bradkim06/eeg_hw/README.md

# Project Goal

기존 외주 뇌파모듈을 더 좋은 성능과 가격으로 대체

## Schematic

[v0.2-dev](./doc/eeg.pdf)
