bradkim06/eeg_hw/doc/20240610/pcb_layout_20240610.png

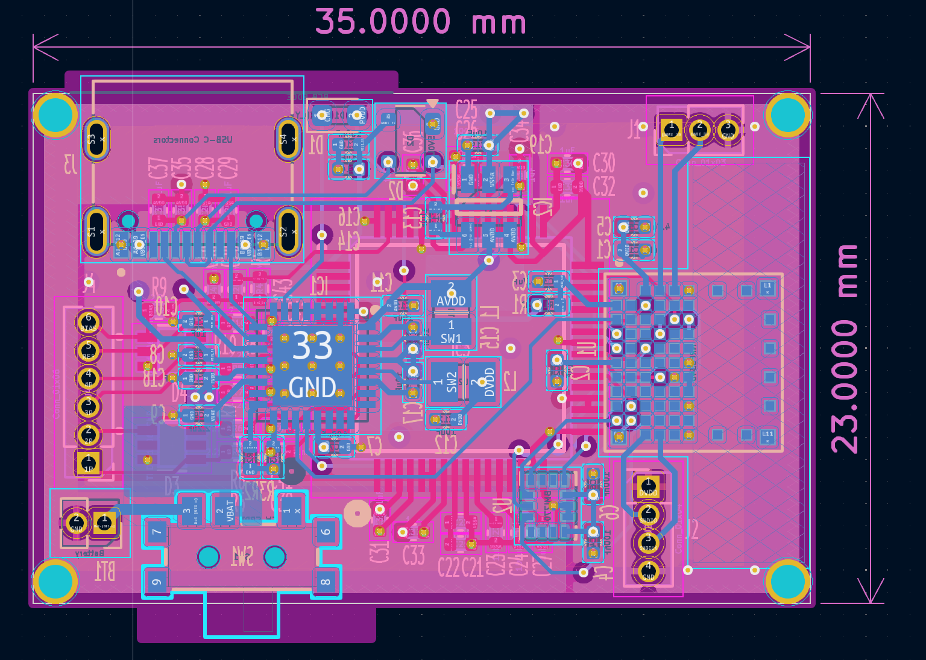
doc/20240610/pcb_layout_20240610.png
