bradkim06/eeg_hw/doc/20240610/schematic_20240610.pdf

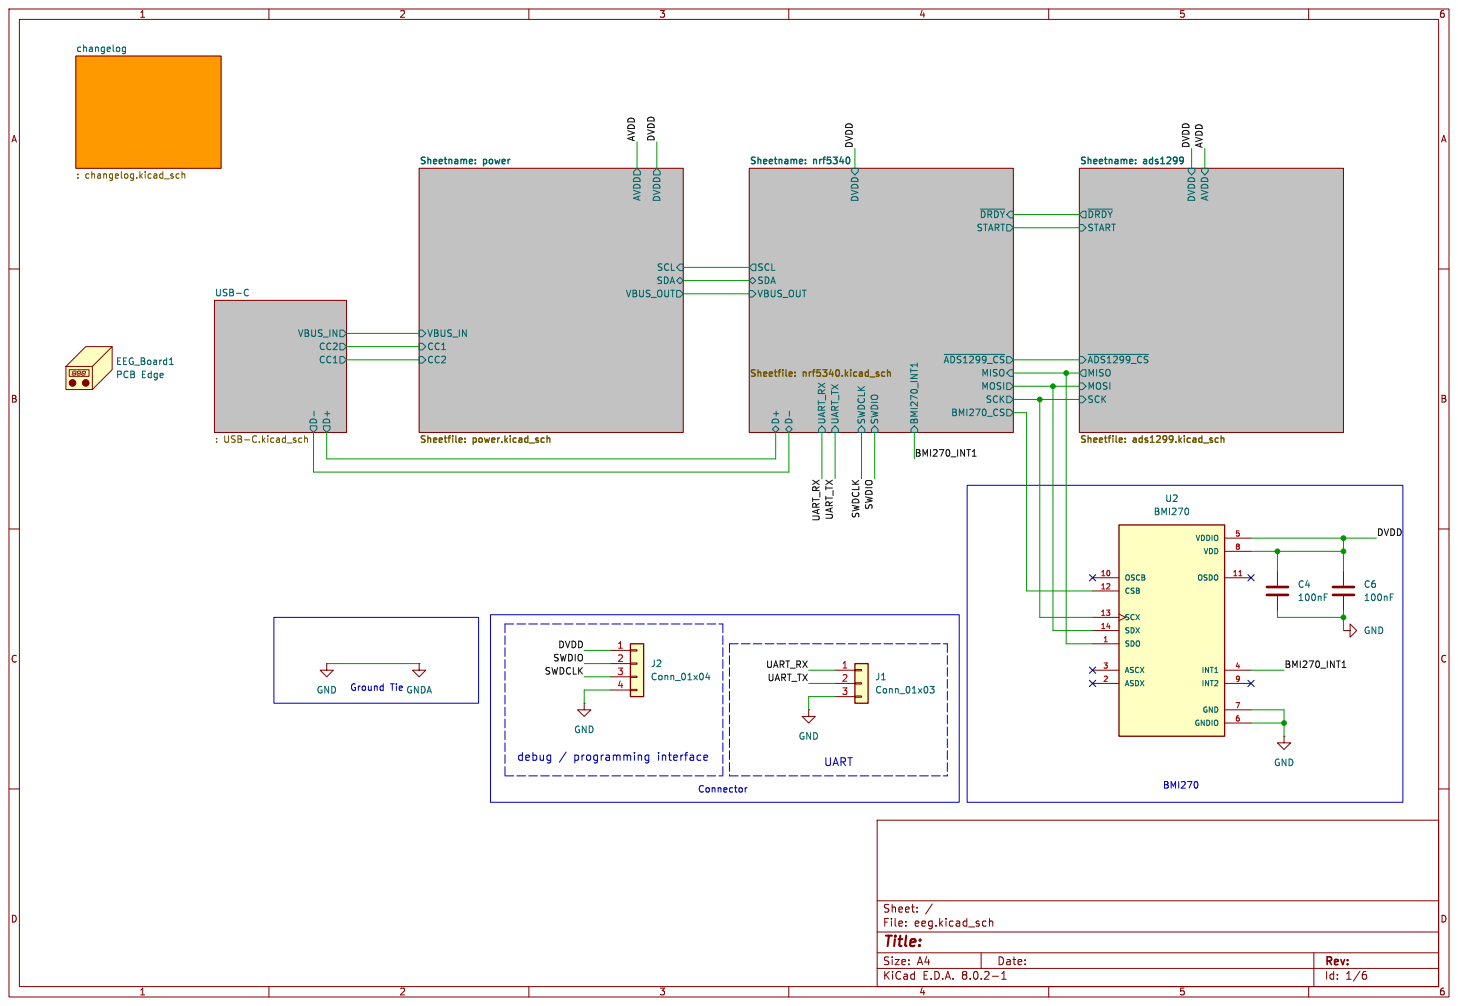
[picture p2: page 1]

Sheetname: power Sheetfile: power.kicad_sch

~{DRDY} START Sheetname: ads1299 Sheetfile: ads1299.kicad_sch

Id: 1/6 Title: File: eeg.kicad_sch Sheet: / D- D+ CC1 CC2 VBUS_IN

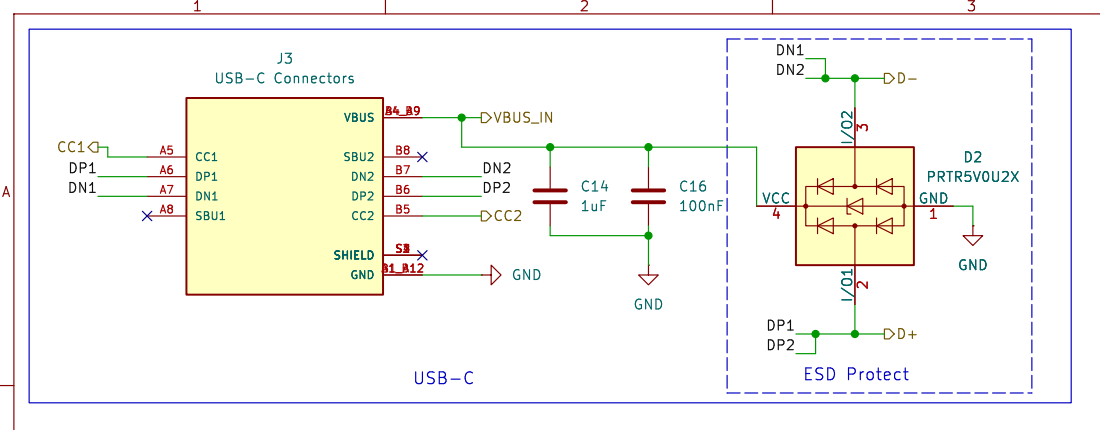
[picture p3: page 2]

Id: 2/6 Title: File: USB-C.kicad_sch Sheet: /USB-C/

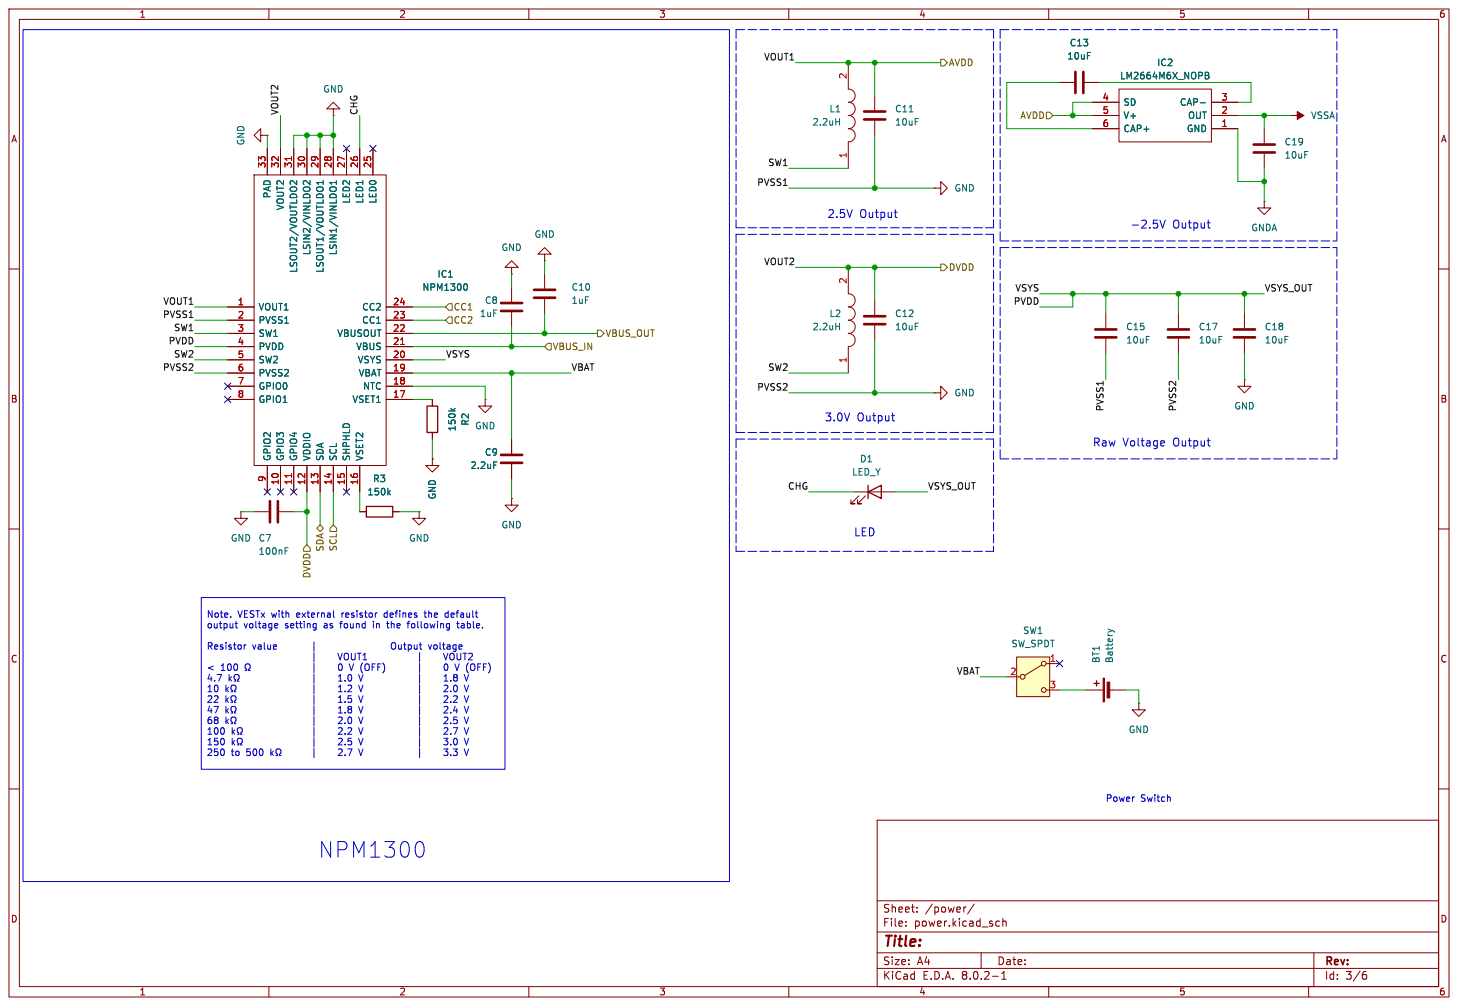
[picture p4: page 3]

1uF GND GND GND GND

Raw Voltage Output 2.5V Output

Id: 3/6 Title: File: power.kicad_sch Sheet: /power/ C9

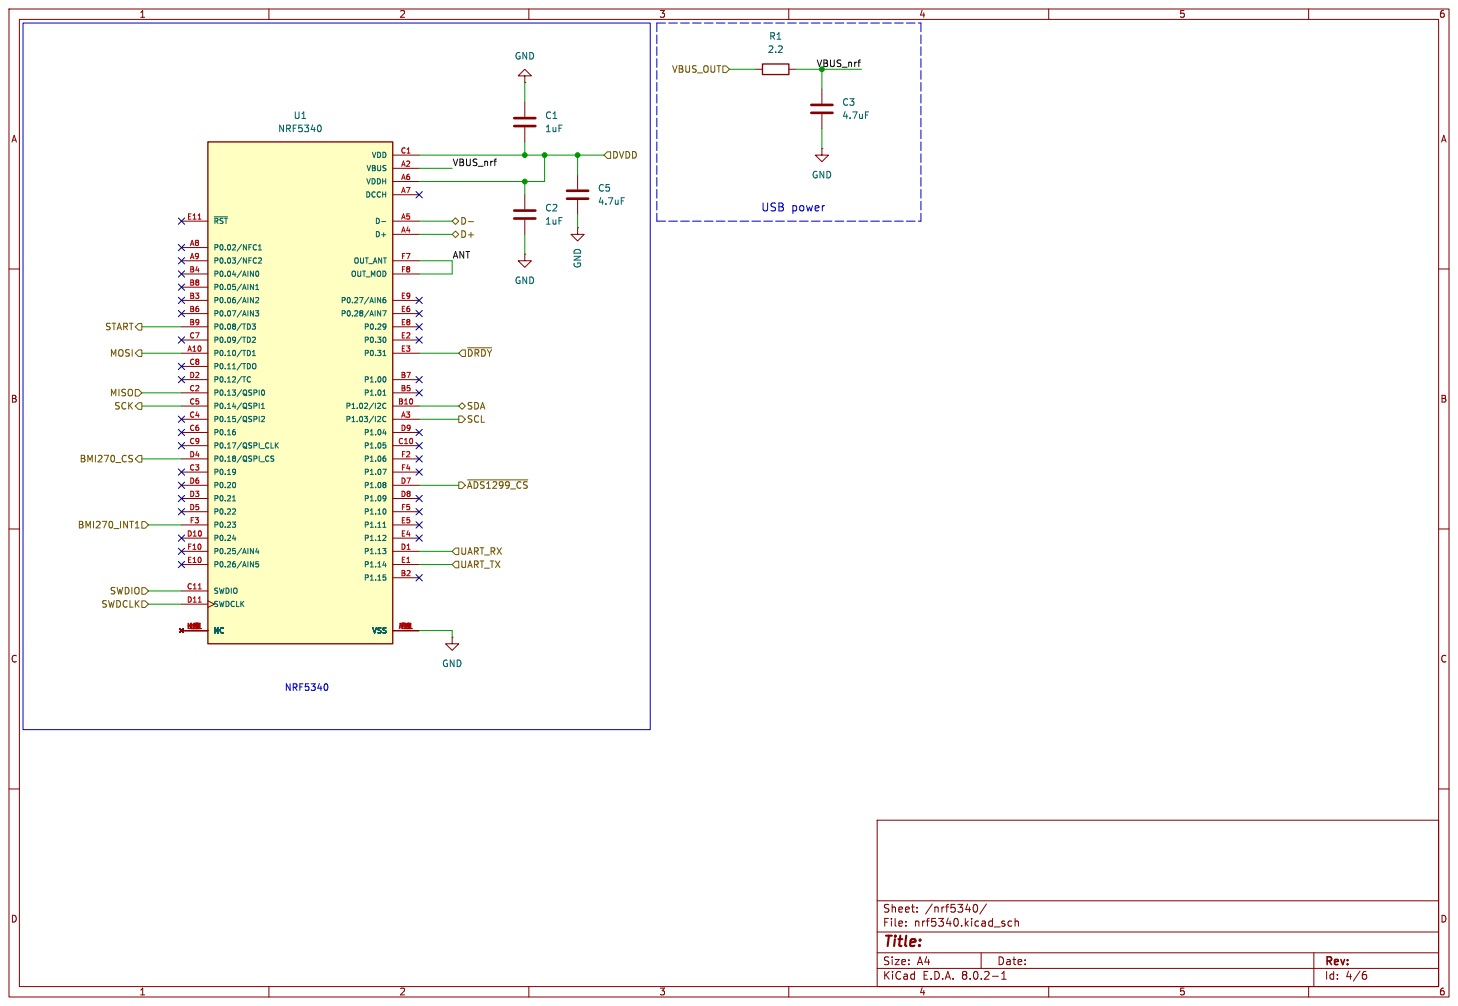
[picture p5: page 4]

Id: 4/6 Title: File: nrf5340.kicad_sch Sheet: /nrf5340/ GND

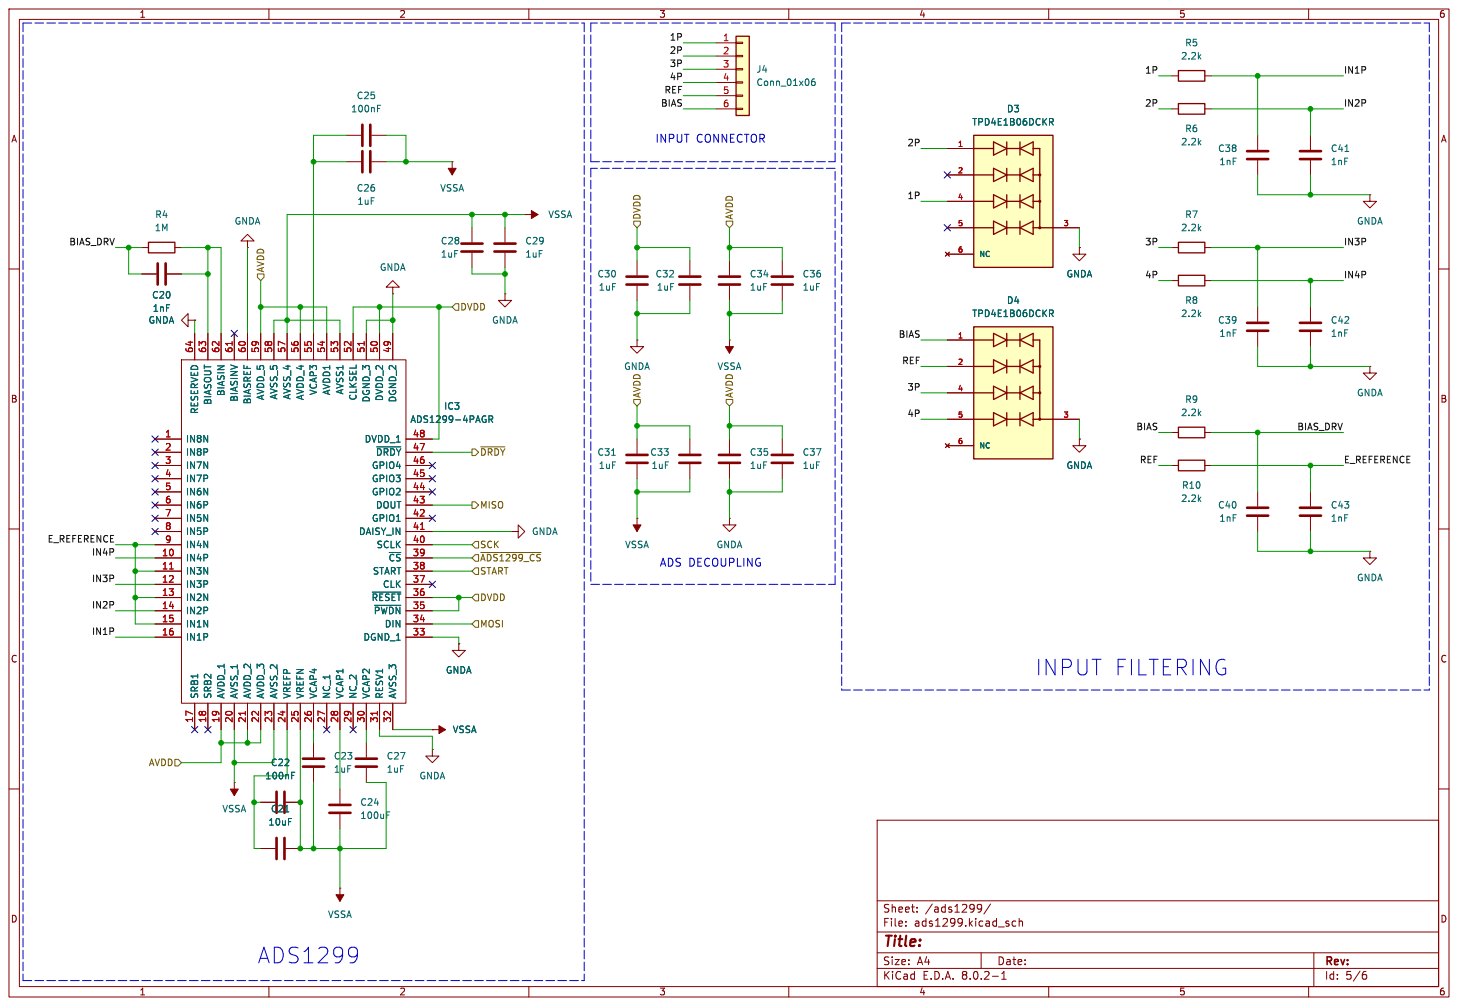
[picture p6: page 5]

Id: 5/6 Title: File: ads1299.kicad_sch Sheet: /ads1299/

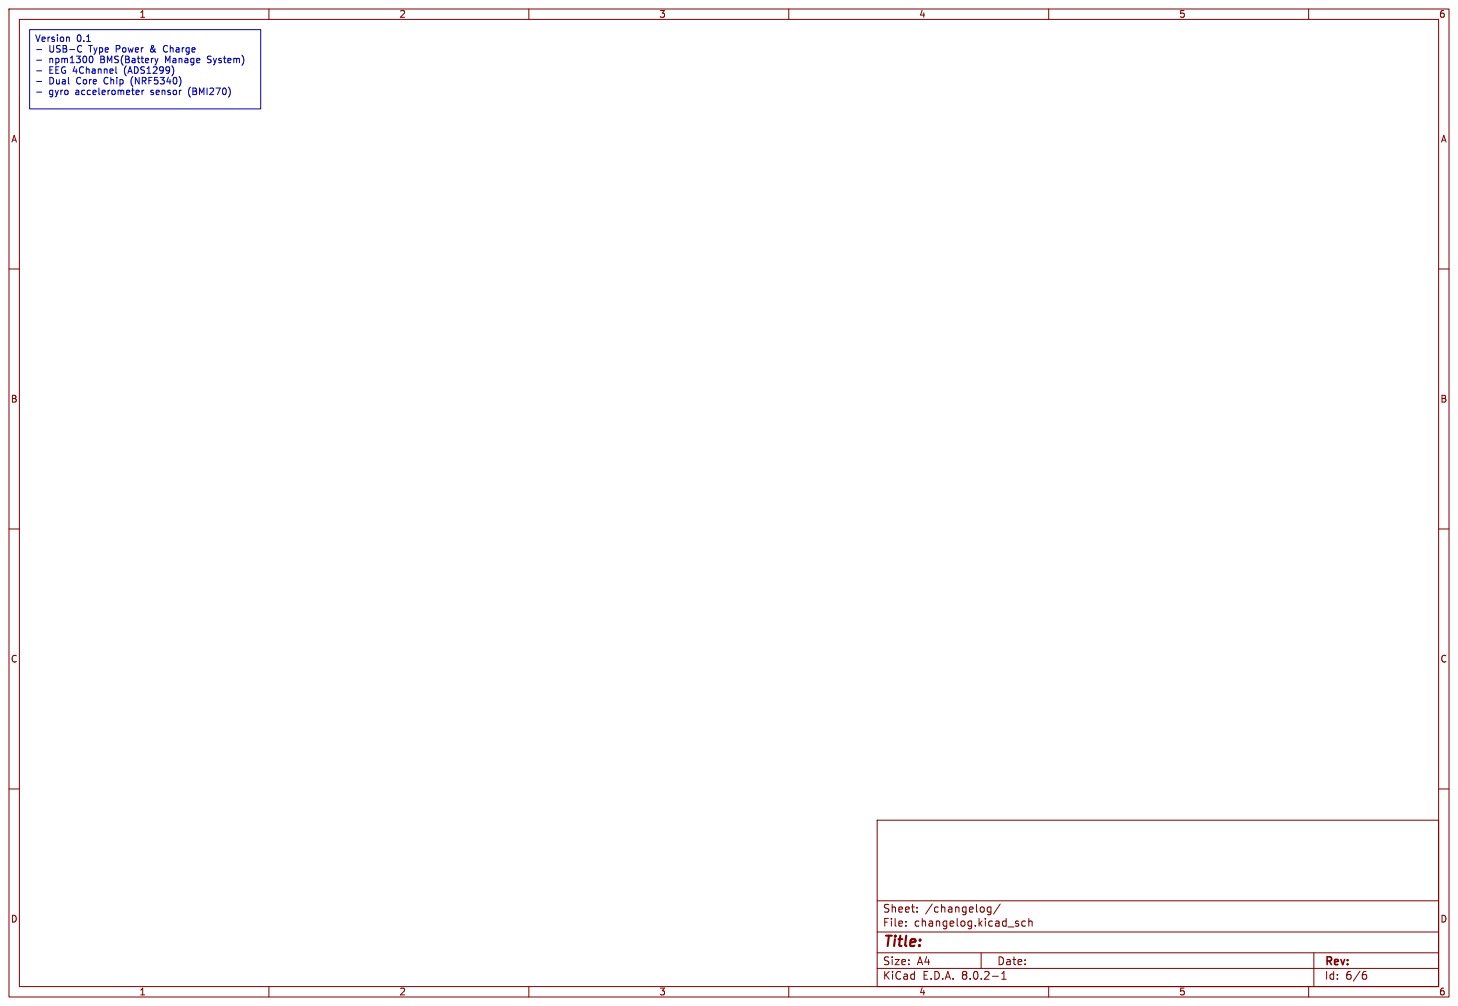
[picture p7: page 6]

Version 0.1
- USB-C Type Power & Charge
- EEG 4Channel (ADS1299)
- Dual Core Chip (NRF5340)

Id: 6/6 Title: File: changelog.kicad_sch Sheet: /changelog/
