bradkim06/eeg_hw/doc/eeg.pdf

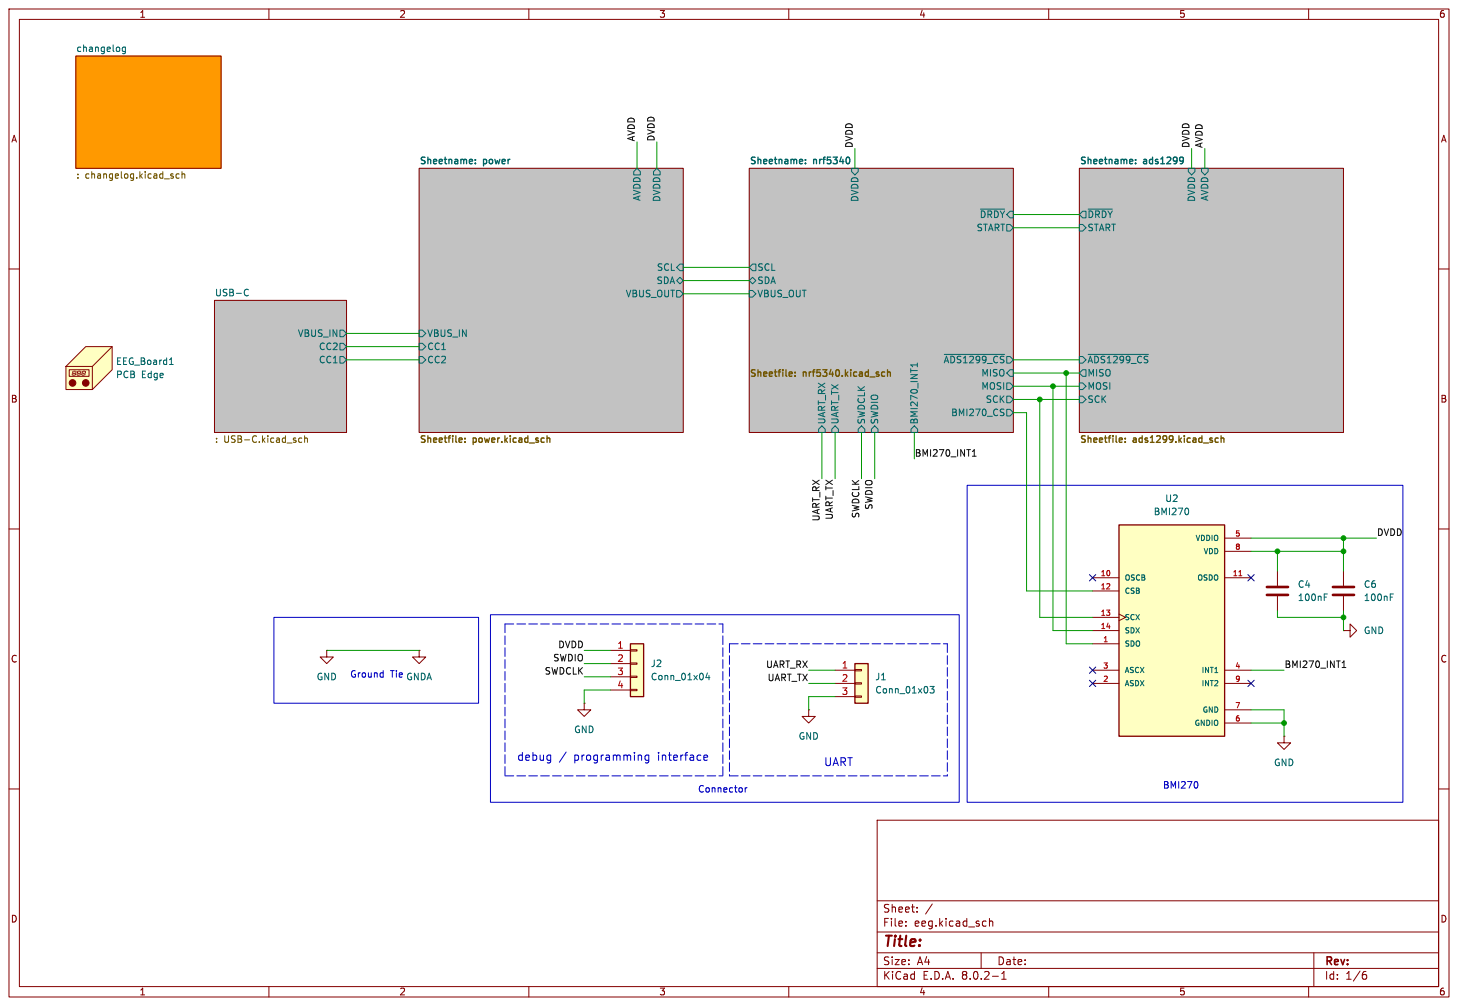
[picture p8: page 1]

UART_TX AVDD
Sheetname: power Sheetfile: power.kicad_sch

~{DRDY} START Sheetname: ads1299 Sheetfile: ads1299.kicad_sch SCL SDA

Id: 1/6 Title: File: eeg.kicad_sch Sheet: /

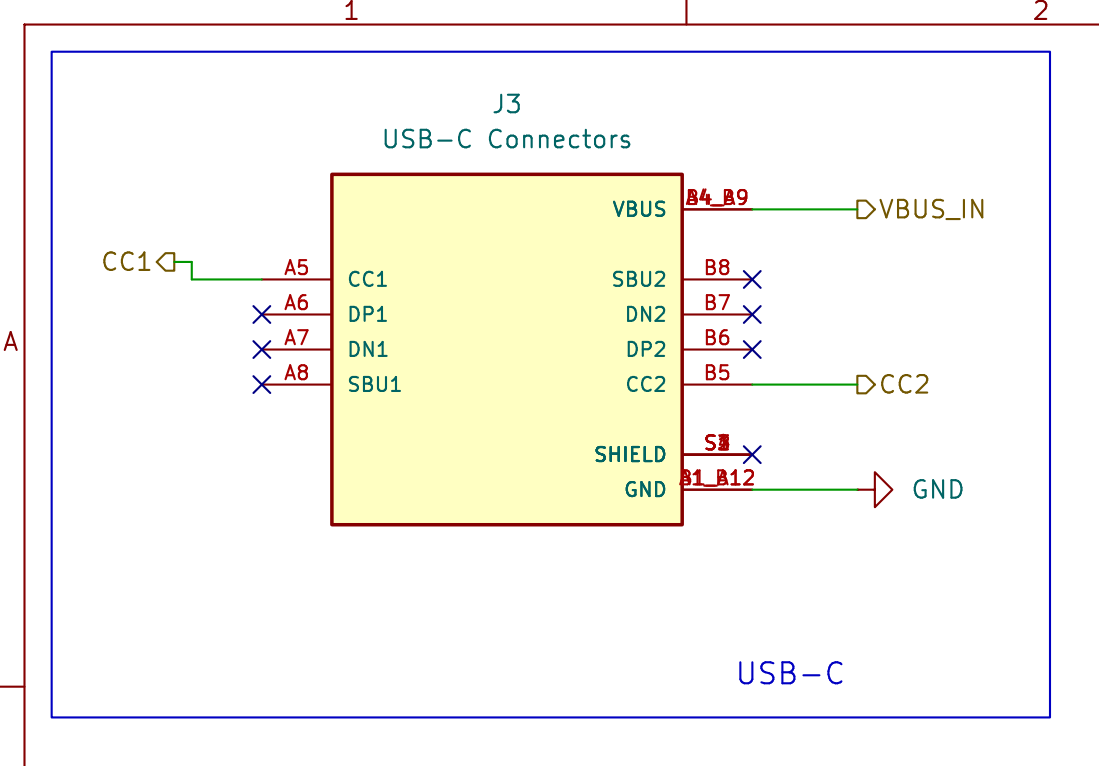
[picture p9: page 2]

Id: 2/6 Title: File: USB-C.kicad_sch Sheet: /USB-C/

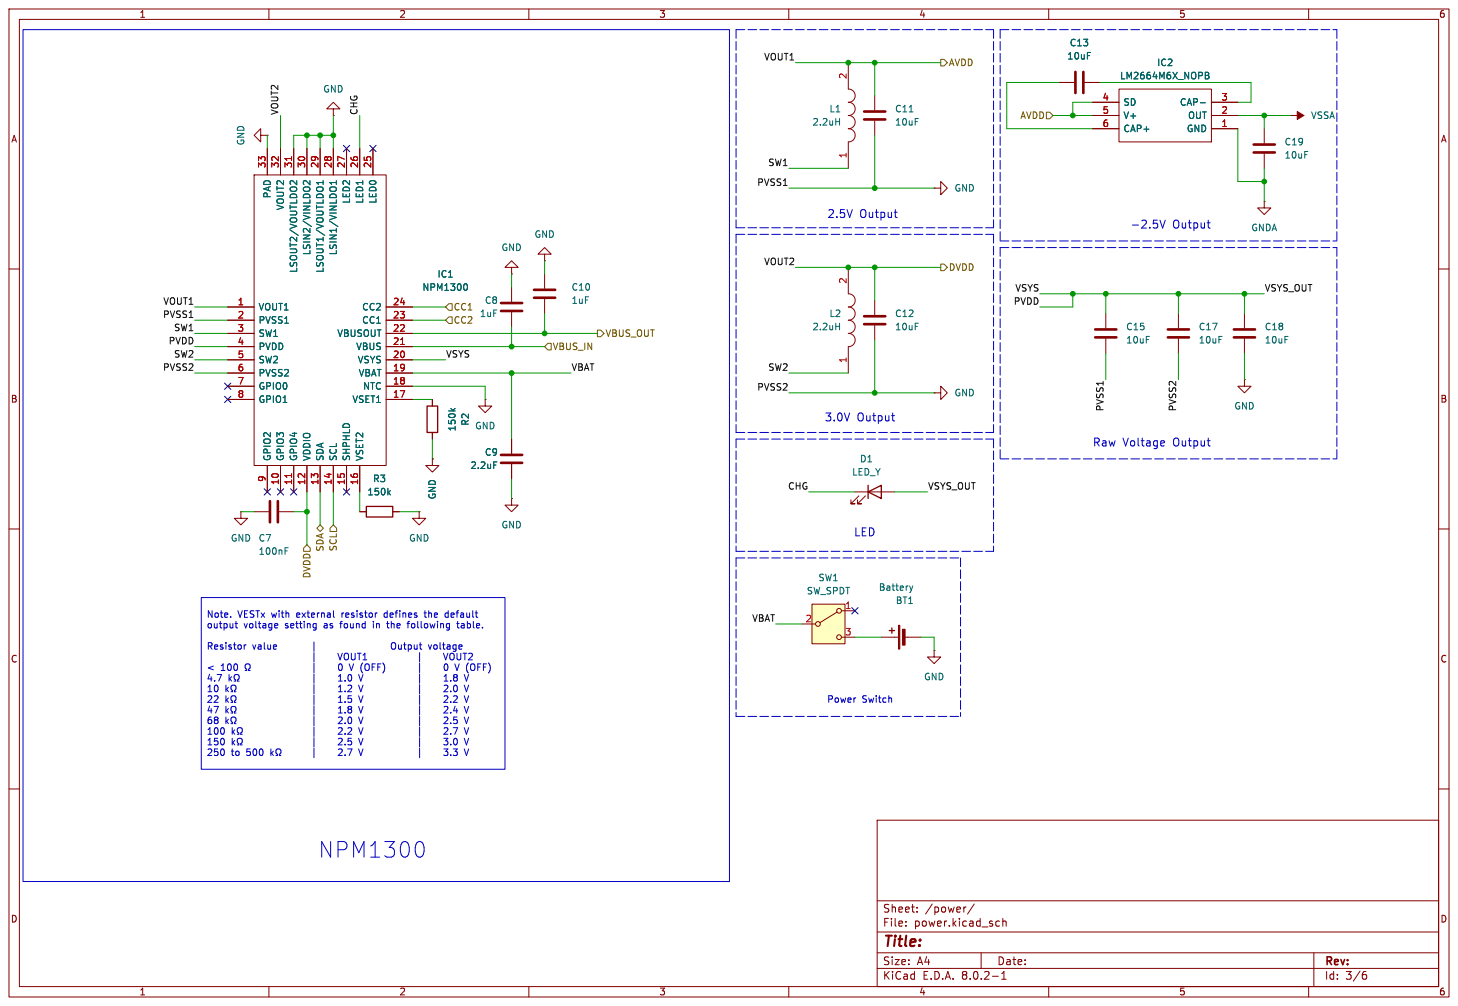
[picture p10: page 3]

Id: 3/6 Title: File: power.kicad_sch Sheet: /power/ C9

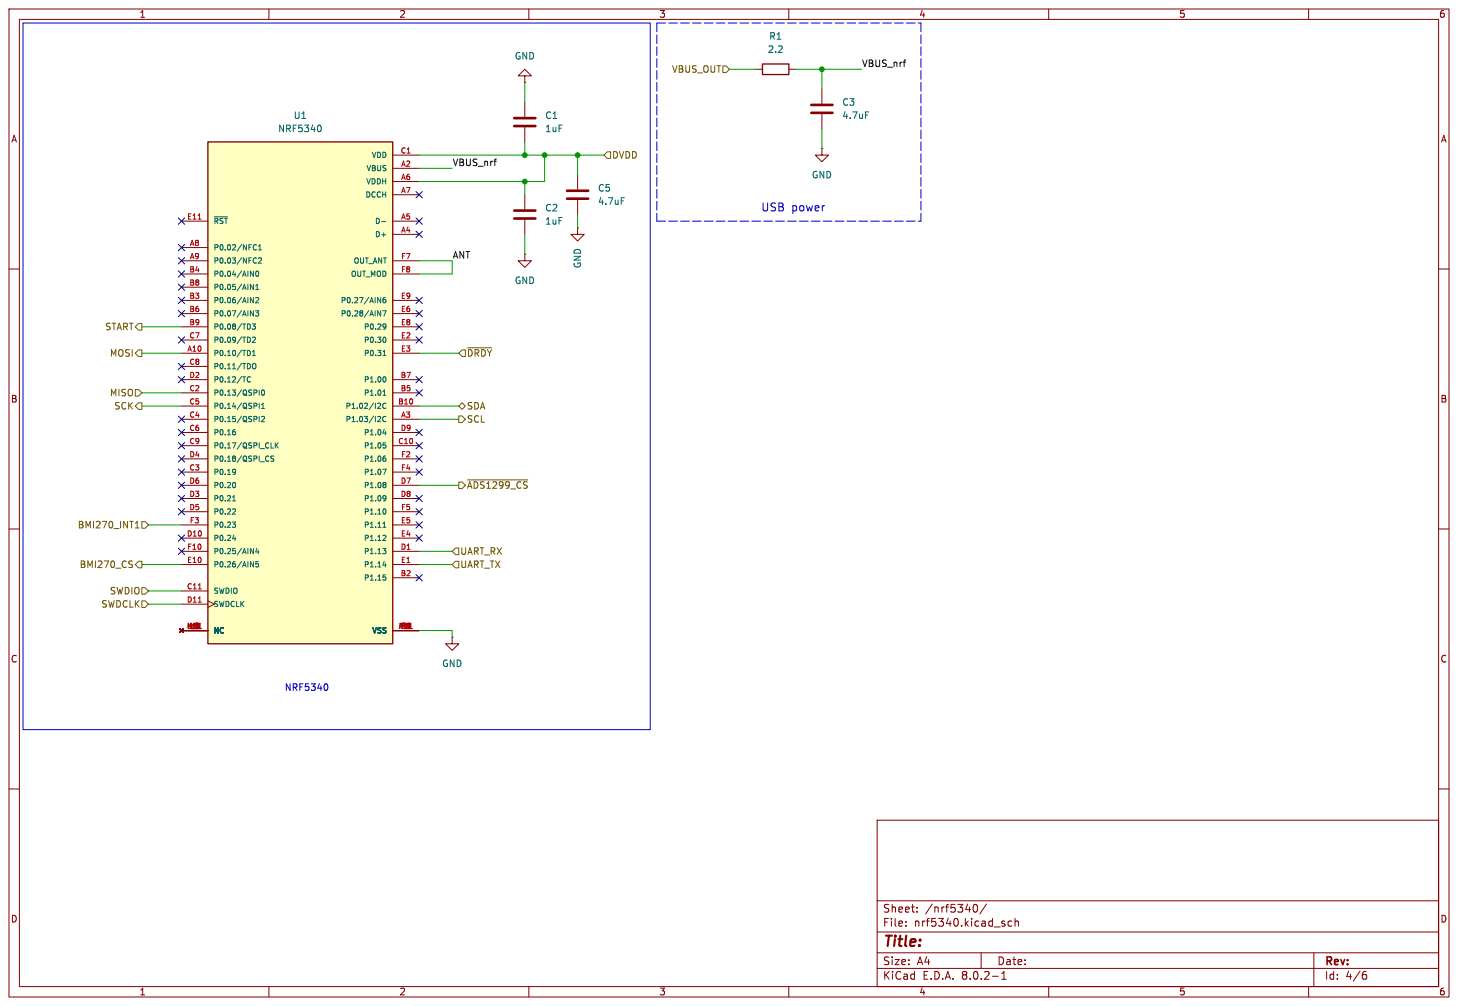
[picture p11: page 4]

START MOSI BMI270_INT1 SCK MISO

Id: 4/6 Title: File: nrf5340.kicad_sch Sheet: /nrf5340/

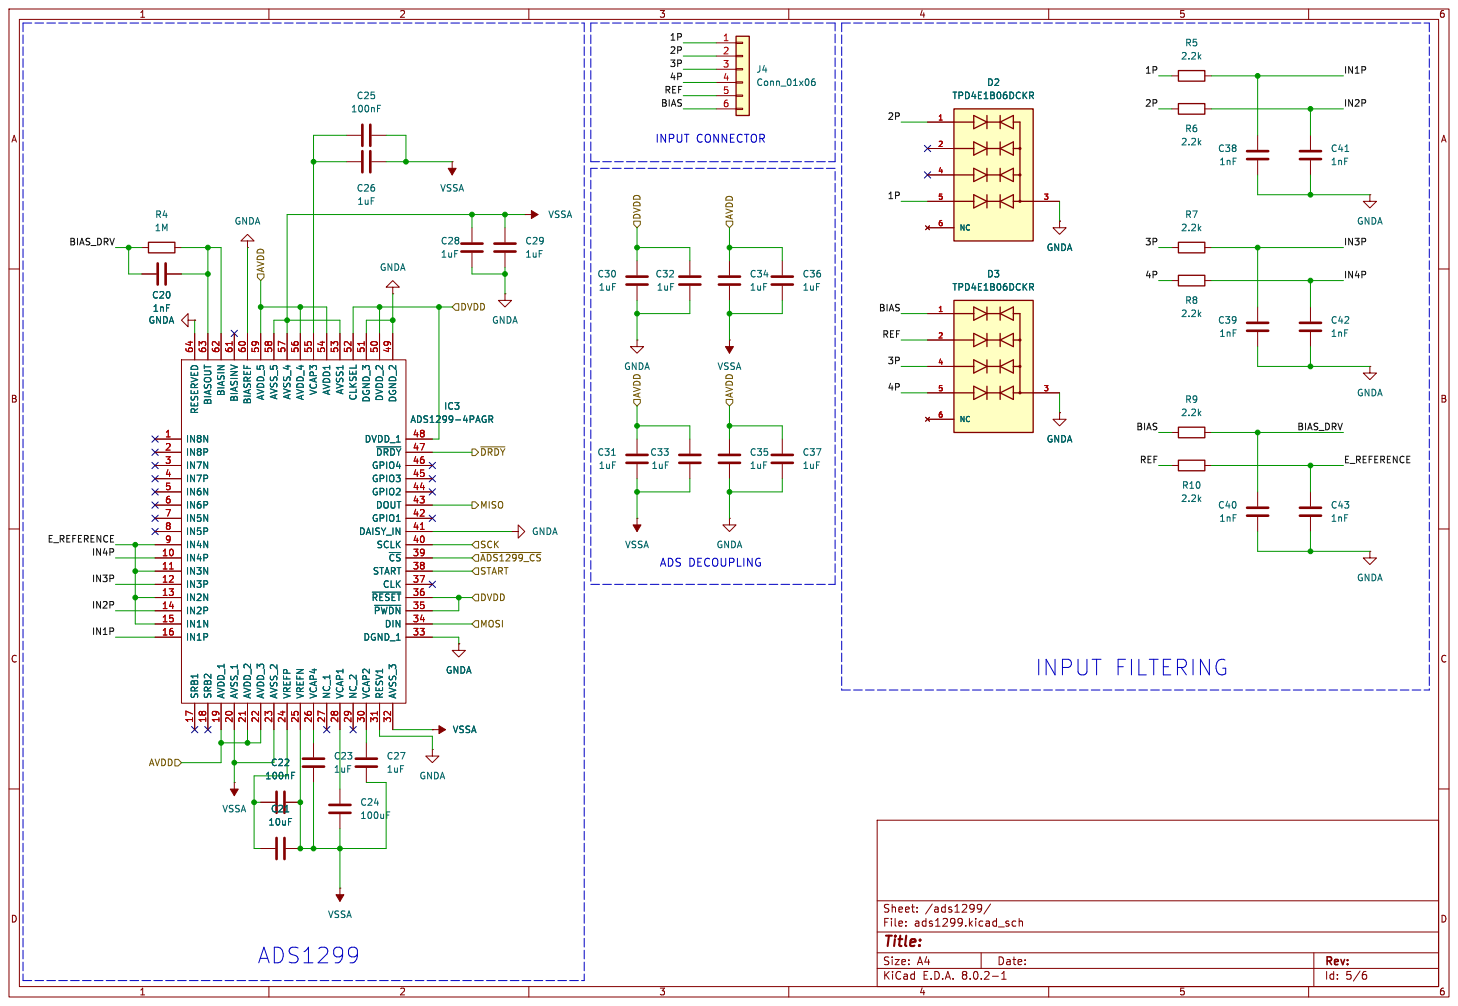
[picture p12: page 5]

Id: 5/6 Title: File: ads1299.kicad_sch Sheet: /ads1299/

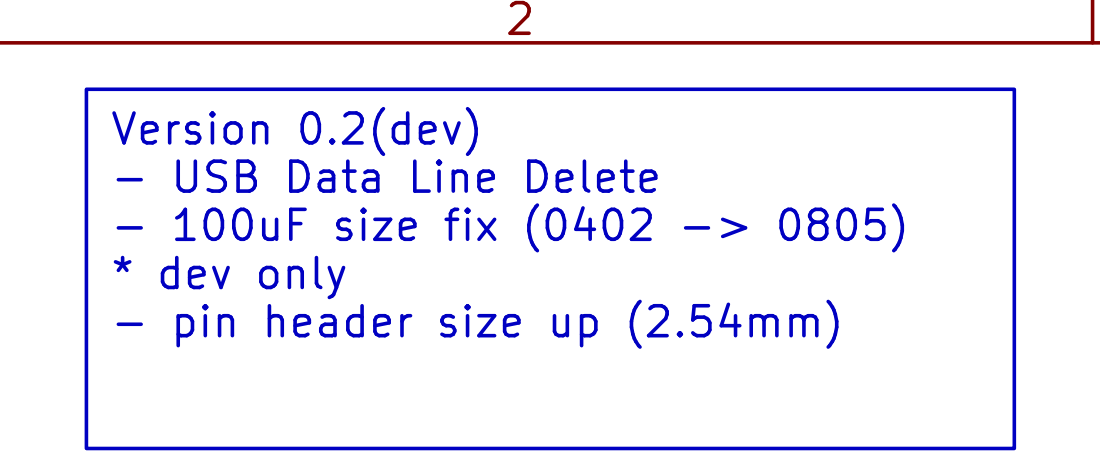
[picture p13: page 6]

- pin header size up (2.54mm) Version 0.1
- USB-C Type Power & Charge
- EEG 4Channel (ADS1299)
- Dual Core Chip (NRF5340)

Version 0.2(dev)
- USB Data Line Delete

Id: 6/6 Title: File: changelog.kicad_sch Sheet: /changelog/
