bradkim06/eeg_hw/eeg.kicad_pcb

## KiCad design eeg.kicad_pcb (2024-06-13)

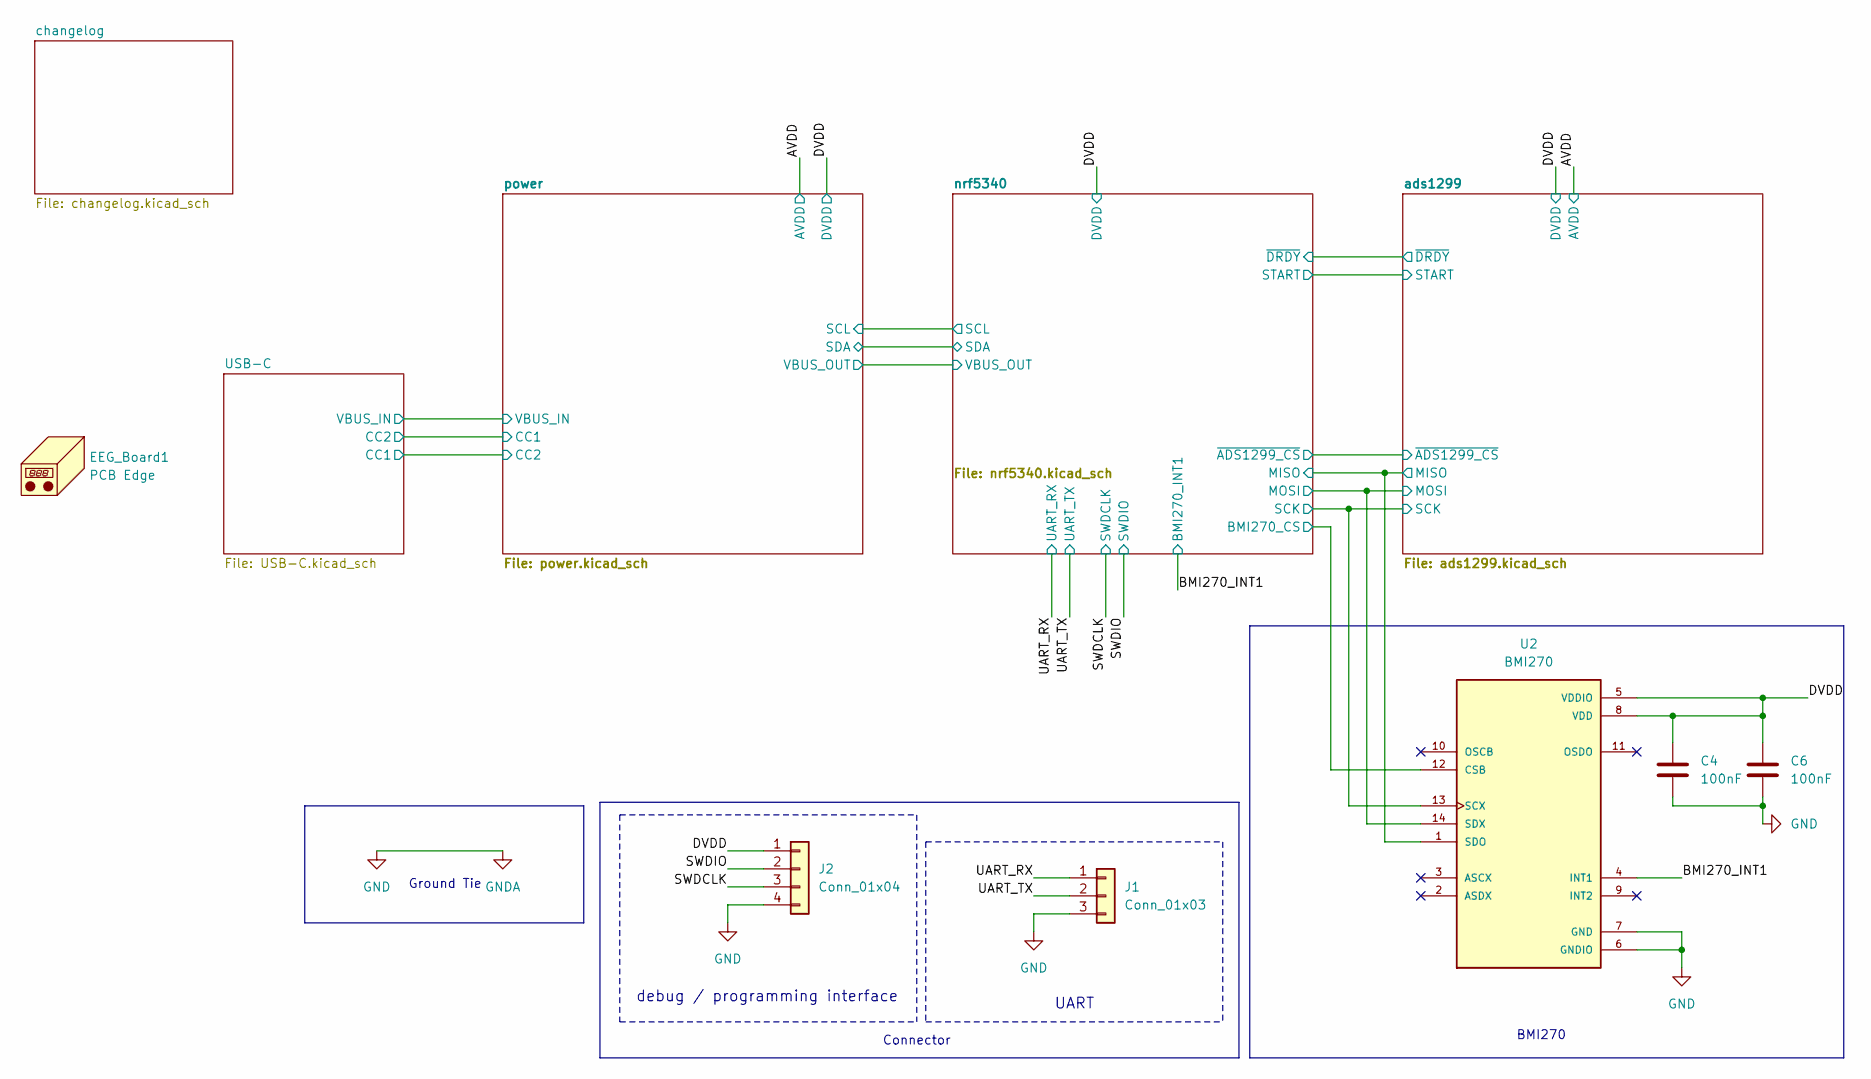
[picture p14: schematic eeg.kicad_sch]

Parts:
C4, C6: 100nF; C_0402_1005Metric; MANUFACTURER_PART_NUMBER GRM155R71C104KA88D
EEG_Board1: PCB Edge; eeg
J1: Conn_01x03; PinHeader_1x03_P2.54mm_Vertical; MANUFACTURER_PART_NUMBER 1.25T-3A
J2: Conn_01x04; PinHeader_1x04_P2.54mm_Vertical; MANUFACTURER_PART_NUMBER 1.25T-4A
U2: BMI270; XDCR_BMI270; MANUFACTURER_PART_NUMBER BMI270

Connections:
/BMI270_INT1: U2.4 (INT1); also elsewhere on the board
/DVDD: C4.1, C6.1, J2.1, U2.5 (VDDIO), U2.8 (VDD); also elsewhere on the board
/SWDCLK: J2.3; also elsewhere on the board
/SWDIO: J2.2; also elsewhere on the board
/UART_RX: J1.1; also elsewhere on the board
/UART_TX: J1.2; also elsewhere on the board
/ads1299/MISO: U2.1 (SDO); also elsewhere on the board
/ads1299/MOSI: U2.14 (SDX); also elsewhere on the board
/ads1299/SCK: U2.13 (SCX); also elsewhere on the board
/nrf5340/BMI270_CS: U2.12 (CSB); also elsewhere on the board
GND: C4.2, C6.2, J1.3, J2.4, U2.6 (GNDIO), U2.7 (GND); also elsewhere on the board

Notes on the sheet:
Ground Tie
UART
Connector
BMI270
debug / programming interface

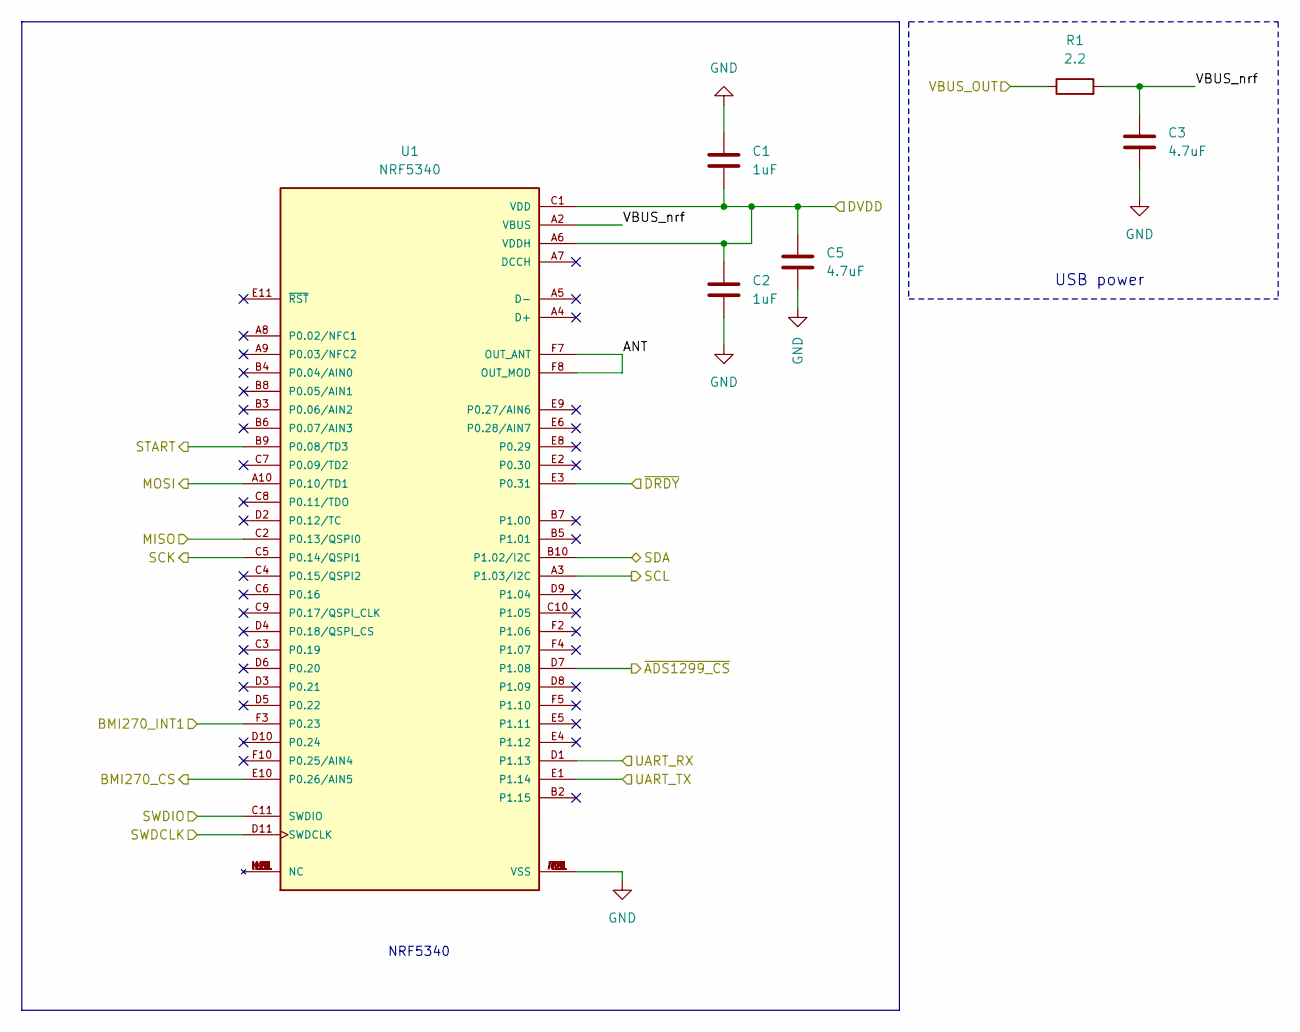
[picture p15: schematic nrf5340.kicad_sch]

Parts:
C1, C2: 1uF; C_0402_1005Metric; MANUFACTURER_PART_NUMBER GRM155R61A105KE15D
C3, C5: 4.7uF; C_0402_1005Metric; MANUFACTURER_PART_NUMBER GRM155R61A475MEAAD
R1: 2.2; R_0402_1005Metric; MANUFACTURER_PART_NUMBER RC0402FR-072R2L
U1: NRF5340; XCVR_ISP2053-AX-RS; PARTREV R6

Connections:
/BMI270_INT1: U1.F3 (P0.23); also elsewhere on the board
/DVDD: C1.2, C2.1, C5.1, U1.A6 (VDDH), U1.C1 (VDD); also elsewhere on the board
/SWDCLK: U1.D11 (SWDCLK); also elsewhere on the board
/SWDIO: U1.C11 (SWDIO); also elsewhere on the board
/UART_RX: U1.D1 (P1.13); also elsewhere on the board
/UART_TX: U1.E1 (P1.14); also elsewhere on the board
/ads1299/MISO: U1.C2 (P0.13/QSPI0); also elsewhere on the board
/ads1299/MOSI: U1.A10 (P0.10/TD1); also elsewhere on the board
/ads1299/SCK: U1.C5 (P0.14/QSPI1); also elsewhere on the board
/ads1299/START: U1.B9 (P0.08/TD3); also elsewhere on the board
/ads1299/~ADS1299_CS: U1.D7 (P1.08); also elsewhere on the board
/ads1299/~DRDY: U1.E3 (P0.31); also elsewhere on the board
/nrf5340/ANT: U1.F7 (OUT_ANT), U1.F8 (OUT_MOD)
/nrf5340/BMI270_CS: U1.E10 (P0.26/AIN5); also elsewhere on the board
/nrf5340/SCL: U1.A3 (P1.03/I2C); also elsewhere on the board
/nrf5340/SDA: U1.B10 (P1.02/I2C); also elsewhere on the board
/nrf5340/VBUS_OUT: R1.1; also elsewhere on the board
/nrf5340/VBUS_nrf: C3.1, R1.2, U1.A2 (VBUS)
GND: C1.1, C2.2, C3.2, C5.2, U1.A1 (VSS), U1.A11 (VSS), U1.E7 (VSS), U1.F1 (VSS), U1.F6 (VSS), U1.F9 (VSS), U1.F11 (VSS); also elsewhere on the board

Notes on the sheet:
NRF5340
USB power

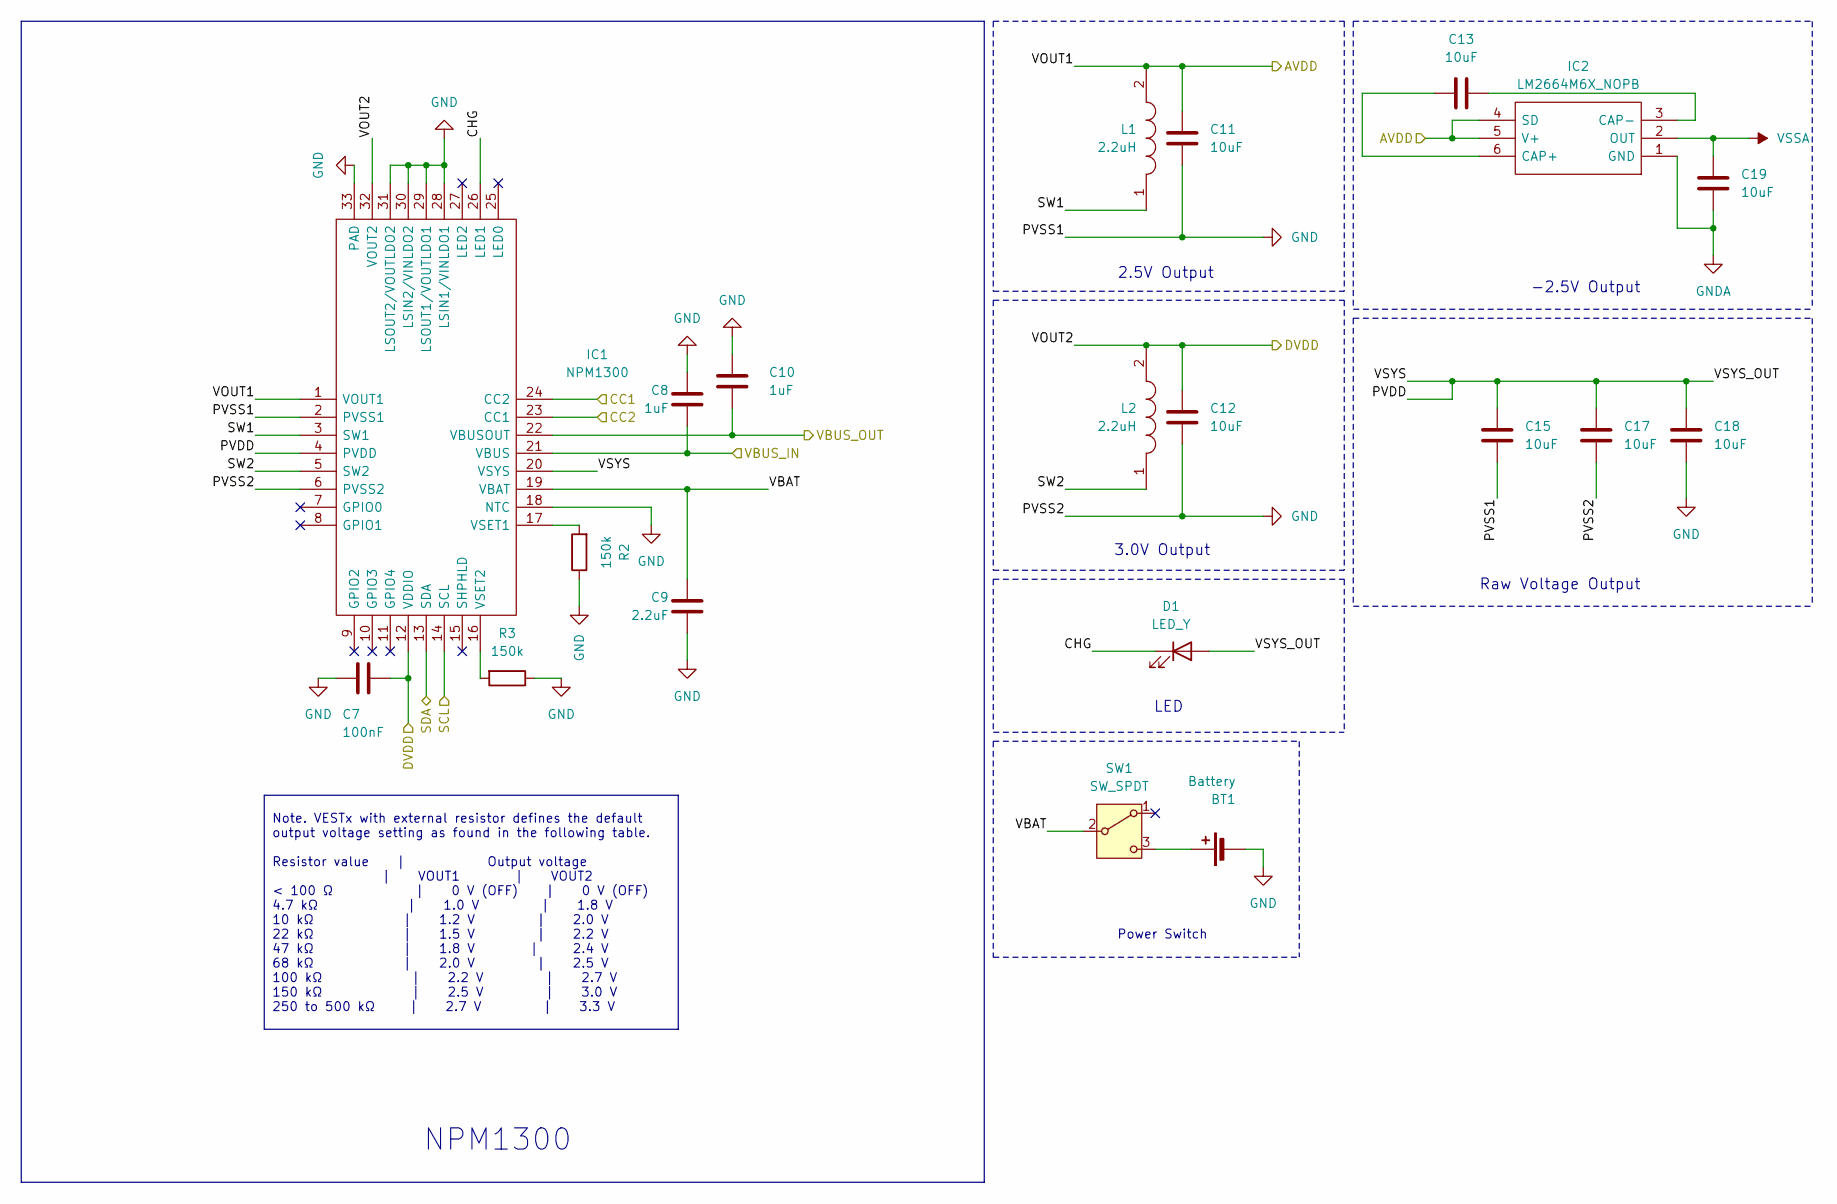
[picture p16: schematic power.kicad_sch]

Parts:
BT1: Battery; PinHeader_1x02_P1.27mm_Vertical; MANUFACTURER_PART_NUMBER 1.25T-2A
C7: 100nF; C_0402_1005Metric; MANUFACTURER_PART_NUMBER GRM155R71C104KA88D
C8, C10: 1uF; C_0402_1005Metric; MANUFACTURER_PART_NUMBER GRM155R61A105KE15D
C9: 2.2uF; C_0402_1005Metric; MANUFACTURER_PART_NUMBER GRM155Z71A225KE01D
C11, C12, C13, C15, C17, C18, C19: 10uF; C_0402_1005Metric; MANUFACTURER_PART_NUMBER GRM155R61A106ME44D
D1: LED_Y; LED_0603_1608Metric; MANUFACTURER_PART_NUMBER 19-213/Y2C-CQ2R2L/3T(CY)
IC1: NPM1300; QFN50P500X500X90-33N; Manufacturer_Part_Number NPM1300-QEAA-R; Mouser Part Number 949-NPM1300-QEAA-R
IC2: LM2664M6X_NOPB; SOT95P280X145-6N; Manufacturer_Part_Number LM2664M6X/NOPB; Mouser Part Number 926-LM2664M6X/NOPB
L1, L2: 2.2uH; INDC2016X100N; Manufacturer_Part_Number MLP2016H2R2MT0S1; Mouser Part Number 810-MLP2016H2R2MT0S1
R2, R3: 150k; R_0402_1005Metric; MANUFACTURER_PART_NUMBER RC0402FR-07150KL
SW1: SW_SPDT; MK-12C02-G020_GSW; MANUFACTURER_PART_NUMBER MK-12C02-G020

Connections:
/AVDD: C11.2, IC1.1 (VOUT1), IC2.4 (SD), IC2.5 (V+), L1.2; also elsewhere on the board
/DVDD: C7.1, C12.2, IC1.12 (VDDIO), IC1.32 (VOUT2), L2.2; also elsewhere on the board
/USB-C/CC1: IC1.23 (CC1); also elsewhere on the board
/USB-C/CC2: IC1.24 (CC2); also elsewhere on the board
/USB-C/VBUS_IN: C8.1, IC1.21 (VBUS); also elsewhere on the board
/nrf5340/SCL: IC1.14 (SCL); also elsewhere on the board
/nrf5340/SDA: IC1.13 (SDA); also elsewhere on the board
/nrf5340/VBUS_OUT: C10.1, IC1.22 (VBUSOUT); also elsewhere on the board
/power/CHG: D1.1 (K), IC1.26 (LED1)
/power/PVDD: C15.2, C17.2, C18.2, D1.2 (A), IC1.4 (PVDD), IC1.20 (VSYS)
/power/SW1: IC1.3 (SW1), L1.1
/power/SW2: IC1.5 (SW2), L2.1
/power/VBAT: C9.2, IC1.19 (VBAT), SW1.2 (B)
GND: BT1.2 (-), C7.2, C8.2, C9.1, C10.2, C11.1, C12.1, C15.1, C17.1, C18.1, C19.1, IC1.2 (PVSS1), IC1.6 (PVSS2), IC1.18 (NTC), IC1.28 (LSIN1/VINLDO1), IC1.29 (LSOUT1/VOUTLDO1), IC1.30 (LSIN2/VINLDO2), IC1.31 (LSOUT2/VOUTLDO2), IC1.33 (PAD), IC2.1 (GND), R2.1, R3.1; also elsewhere on the board
unnamed: BT1.1 (+), SW1.3 (C)
unnamed: IC1.17 (VSET1), R2.2
unnamed: IC1.16 (VSET2), R3.2
unnamed: C13.1, IC2.6 (CAP+)
unnamed: C13.2, IC2.3 (CAP-)
VSSA: C19.2, IC2.2 (OUT); also elsewhere on the board

Notes on the sheet:
Note. VESTx with external resistor defines the default output voltage setting as found in the following table. Resistor value | Output voltage | VOUT1 | VOUT2 < 100 Ω | 0 V (OFF) | 0 V (OFF) 4.7 kΩ | 1.0 V | 1.8 V 10 kΩ | 1.2 V | 2.0 V 22 kΩ | 1.5 V | 2.2 V 47 kΩ | 1.8 V | 2.4 V 68 kΩ | 2.0 V | 2.5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
-2.5V Output
Raw Voltage Output
3.0V Output
Power Switch
2.5V Output
LED
NPM1300

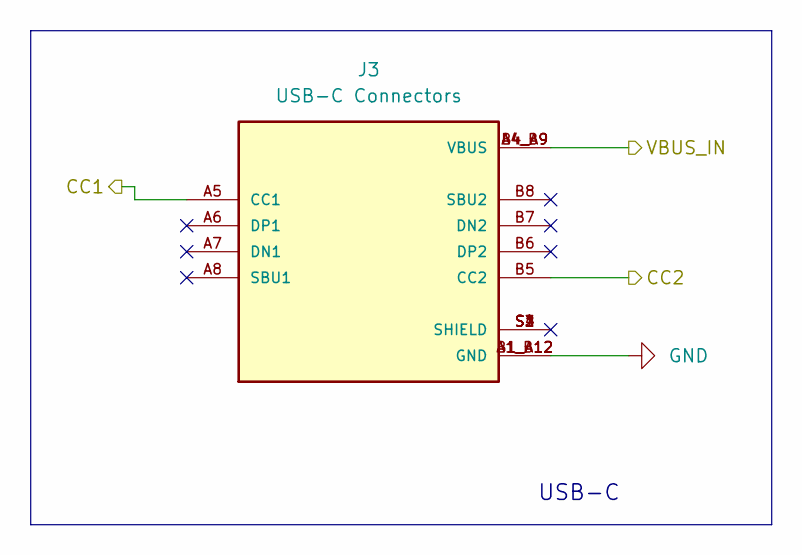
[picture p17: schematic USB-C.kicad_sch]

Parts:
J3: USB-C Connectors; HRO_TYPE-C-31-M-12; PARTREV 2020.12.08

Connections:
/USB-C/CC1: J3.A5 (CC1); also elsewhere on the board
/USB-C/CC2: J3.B5 (CC2); also elsewhere on the board
/USB-C/VBUS_IN: J3.A4_B9 (VBUS), J3.B4_A9 (VBUS); also elsewhere on the board
GND: J3.A1_B12 (GND), J3.B1_A12 (GND); also elsewhere on the board

Notes on the sheet:
USB-C

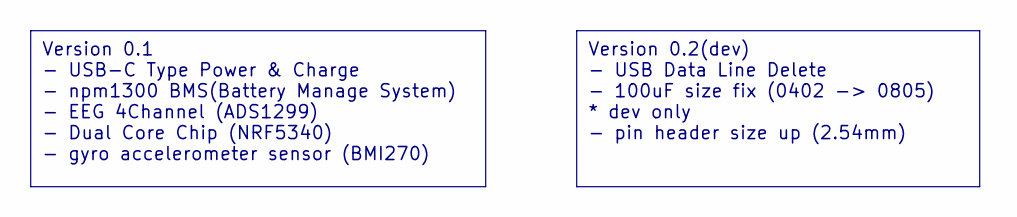
[picture p18: schematic changelog.kicad_sch]

Notes on the sheet:
Version 0.2(dev) - USB Data Line Delete - 100uF size fix (0402 -> 0805) * dev only - pin header size up (2.54mm)
Version 0.1 - USB-C Type Power & Charge - npm1300 BMS(Battery Manage System) - EEG 4Channel (ADS1299) - Dual Core Chip (NRF5340) - gyro accelerometer sensor (BMI270)

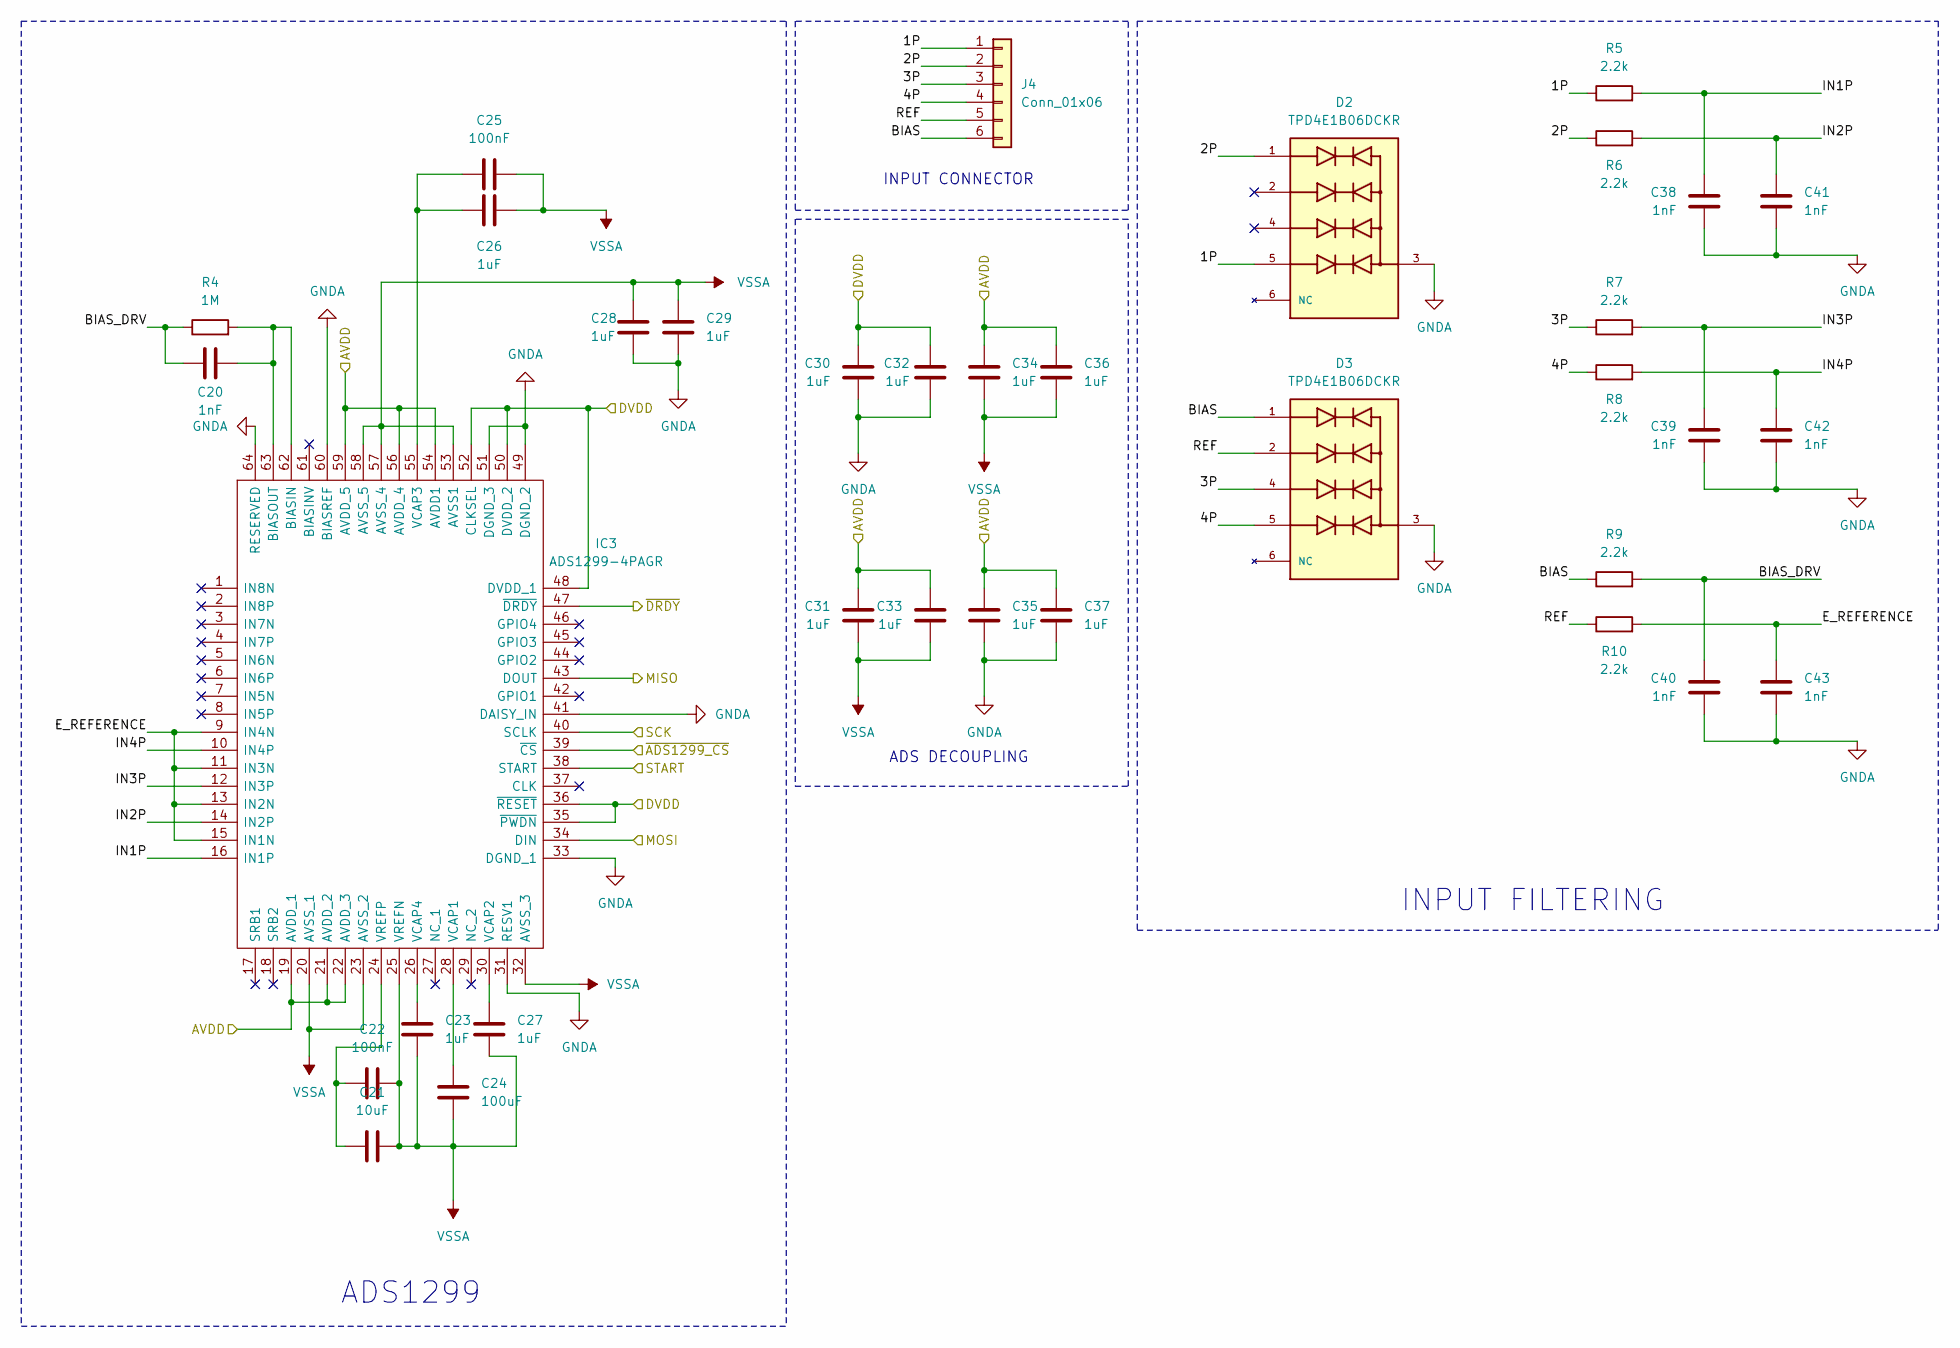
[picture p19: schematic ads1299.kicad_sch]

Parts:
C20, C38, C39, C40, C41, C42, C43: 1nF; C_0402_1005Metric; MANUFACTURER_PART_NUMBER GRM155R71H102KA01D
C21: 10uF; C_0402_1005Metric; MANUFACTURER_PART_NUMBER GRM155R61A106ME44D
C22, C25: 100nF; C_0402_1005Metric; MANUFACTURER_PART_NUMBER GRM155R71C104KA88D
C23, C26, C27, C28, C29, C30, C31, C32, C33, C34, C35, C36, C37: 1uF; C_0402_1005Metric; MANUFACTURER_PART_NUMBER GRM155R61A105KE15D
C24: 100uF; C_0805_2012Metric; MANUFACTURER_PART_NUMBER GRM21BR60J107ME15L
D2, D3: TPD4E1B06DCKR; TVS_TPD4E1B06DCKR; PARTREV C
IC3: ADS1299-4PAGR; QFP50P1200X1200X120-64N; Manufacturer_Part_Number ADS1299-4PAGR; Mouser Part Number 595-ADS1299-4PAGR
J4: Conn_01x06; PinHeader_1x06_P2.54mm_Vertical; MANUFACTURER_PART_NUMBER 1.25T-6A
R4: 1M; R_0402_1005Metric; MANUFACTURER_PART_NUMBER RC0402FR-071ML
R5, R6, R7, R8, R9, R10: 2.2k; R_0402_1005Metric; MANUFACTURER_PART_NUMBER RC0402FR-072K2L

Connections:
/AVDD: C31.2, C33.2, C34.2, C35.2, C36.2, C37.2, IC3.19 (AVDD_1), IC3.21 (AVDD_2), IC3.22 (AVDD_3), IC3.54 (AVDD1), IC3.56 (AVDD_4), IC3.59 (AVDD_5); also elsewhere on the board
/DVDD: C30.2, C32.2, IC3.35 (~PWDN), IC3.36 (~RESET), IC3.48 (DVDD_1), IC3.50 (DVDD_2), IC3.52 (CLKSEL); also elsewhere on the board
/ads1299/1P: D2.5, J4.1, R5.1
/ads1299/2P: D2.1, J4.2, R6.1
/ads1299/3P: D3.4, J4.3, R7.1
/ads1299/4P: D3.5, J4.4, R8.1
/ads1299/BIAS: D3.1, J4.6, R9.1
/ads1299/BIAS_DRV: C20.1, C40.2, R4.1, R9.2
/ads1299/E_REFERENCE: C43.2, IC3.9 (IN4N), IC3.11 (IN3N), IC3.13 (IN2N), IC3.15 (IN1N), R10.2
/ads1299/IN1P: C38.2, IC3.16 (IN1P), R5.2
/ads1299/IN2P: C41.2, IC3.14 (IN2P), R6.2
/ads1299/IN3P: C39.2, IC3.12 (IN3P), R7.2
/ads1299/IN4P: C42.2, IC3.10 (IN4P), R8.2
/ads1299/MISO: IC3.43 (DOUT); also elsewhere on the board
/ads1299/MOSI: IC3.34 (DIN); also elsewhere on the board
/ads1299/REF: D3.2, J4.5, R10.1
/ads1299/SCK: IC3.40 (SCLK); also elsewhere on the board
/ads1299/START: IC3.38 (START); also elsewhere on the board
/ads1299/~ADS1299_CS: IC3.39 (~CS); also elsewhere on the board
/ads1299/~DRDY: IC3.47 (~DRDY); also elsewhere on the board
GND: C28.1, C29.1, C30.1, C32.1, C35.1, C37.1, C38.1, C39.1, C40.1, C41.1, C42.1, C43.1, D2.3, D3.3, IC3.31 (RESV1), IC3.33 (DGND_1), IC3.41 (DAISY_IN), IC3.49 (DGND_2), IC3.51 (DGND_3), IC3.60 (BIASREF), IC3.64 (RESERVED); also elsewhere on the board
unnamed: C20.2, IC3.62 (BIASIN), IC3.63 (BIASOUT), R4.2
unnamed: C24.1, IC3.28 (VCAP1)
unnamed: C27.1, IC3.30 (VCAP2)
unnamed: C25.1, C26.1, IC3.55 (VCAP3)
unnamed: C23.1, IC3.26 (VCAP4)
unnamed: C21.2, C22.1, IC3.24 (VREFP)
VSSA: C21.1, C22.2, C23.2, C24.2, C25.2, C26.2, C27.2, C28.2, C29.2, C31.1, C33.1, C34.1, C36.1, IC3.20 (AVSS_1), IC3.23 (AVSS_2), IC3.25 (VREFN), IC3.32 (AVSS_3), IC3.53 (AVSS1), IC3.57 (AVSS_4), IC3.58 (AVSS_5); also elsewhere on the board

Notes on the sheet:
ADS DECOUPLING
ADS1299
INPUT CONNECTOR
INPUT FILTERING

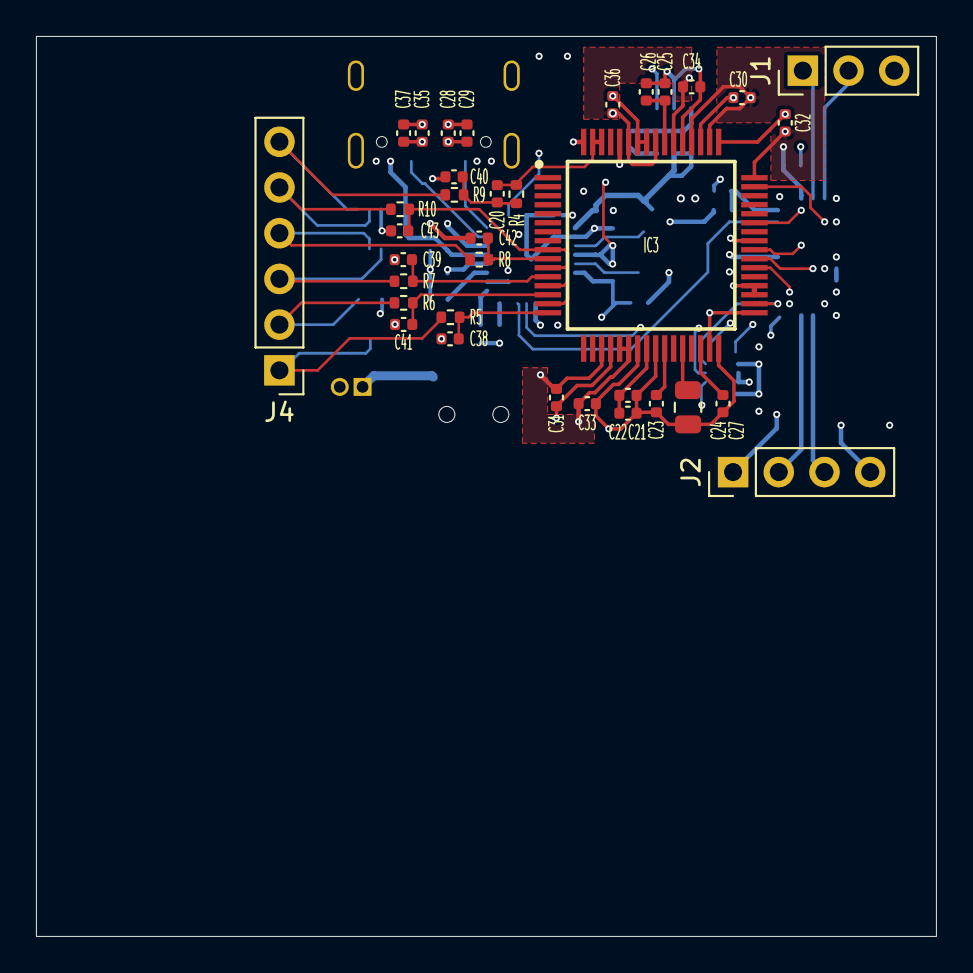
[picture p20: board eeg.kicad_pcb from above]

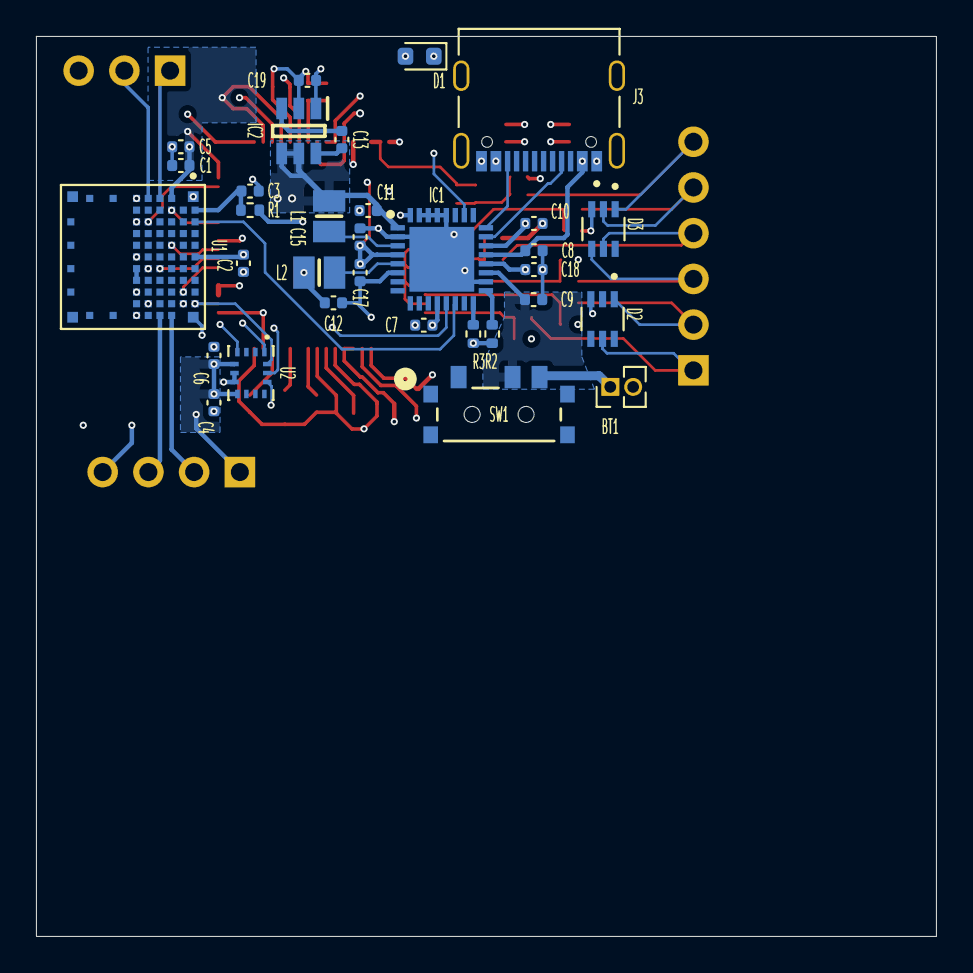
[picture p21: board eeg.kicad_pcb from below]

Board: 6 copper layers, 50.0 x 50.0 mm, 67 parts (32 on the bottom side), 52 nets.
