bradkim06/eeg_hw/(commit log)

2024-05-29 first init
    [BMI270.kicad_sch, POWER SUPPLY.kicad_sch, USB-C.kicad_sch, ads1299.kicad_sch, bom.csv, changelog.kicad_sch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]
2024-05-29 사용하지 않는 폴더 제거(gerber)
    [eeg-B_Courtyard.gbr, eeg-B_Cu.gbr, eeg-B_Fab.gbr, eeg-B_Mask.gbr, eeg-B_Paste.gbr, eeg-B_Silkscreen.gbr, eeg-Edge_Cuts.gbr, eeg-F_Courtyard.gbr]
2024-05-29 schematic pdf init
2024-05-29 사용하지 않는 파일 제거
    [eeg.csv]
2024-06-13 한샘디지텍 견적전 수정
    - Reference Circuit 확인
    - bom 갱신
    - EMC Layout 확인
    - ERC 확인
    - Gerber
    - SMT 요청서
    [eeg-B_Courtyard.gbr, eeg-B_Cu.gbr, eeg-B_Fab.gbr, eeg-B_Mask.gbr, eeg-B_Paste.gbr, eeg-B_Silkscreen.gbr, eeg-Edge_Cuts.gbr, eeg-F_Courtyard.gbr]
2024-06-13 Feat: 개발보드 버전으로 PCB 변경
    수정사항
    단가 감소
    - PCB Board size up (50x50)
    - blind via 제거 (전체 레이아웃 수정)
    - AVDD 전력평면 추가
    - ADS1299 안쓰는핀 GND
    - ADS1299 배치 변경 (Layout Reference 적용)
    개발보드만 적용사항
    - Pin Header size up 1.27 → 2.54mm
    - PCB Size 50x50(mm)
    [USB-C.kicad_sch, ads1299.kicad_sch, changelog.kicad_sch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]
2024-06-13 Doc: Gerber Data V0.2(dev)
    [ads1299.kicad_sch, bom.csv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]
2024-06-18 Doc: schematic PDF 추가
2024-06-20 Doc: Gerber Refresh
    [eeg-B_Courtyard.gbr, eeg-B_Cu.gbr, eeg-B_Fab.gbr, eeg-B_Mask.gbr, eeg-B_Paste.gbr, eeg-B_Silkscreen.gbr, eeg-Edge_Cuts.gbr, eeg-F_Courtyard.gbr]
